himawari422/zynq7010-snore-detect/标定教程.md

# 呼噜声前端 阈值标定教程

> 适用：领航者 ZYNQ7010（ATK-DF7010P）+ Adafruit 3492 PDM 麦克风 + `snore_pdm` 工程
> 目标：把 `alarm_ctrl` 里三个估出来的门限（100 / 400 / 1200）换成**你这块板子、你这个房间**的实测值。

---

## 0. 前置条件（缺一不可）

| ☐ | 条件 | 怎么确认 |
|---|---|---|
| ☐ | 麦克风模块已接到 5 根杜邦线的另一端 | 5 个焊盘 3V/GND/CLK/DAT/SEL 全部接好 |
| ☐ | bit 已下载，板子上电 | 串口每 32ms 有一行 `F00xx P00xx A00xx` |
| ☐ | 串口跳线在 **PL 侧** | 有数据即说明已在 PL 侧 |
| ☐ | 串口助手已关闭 | **同一个 COM 口不能被两个程序占用** |
| ☐ | 环境就是实际使用环境 | 白天教室标定、夜里宿舍用 = 白标定 |

**先跑一次自检**：

```bash
python scripts\snore_mon.py COM7 3
```

能打印出帧统计就继续；打印 `收到 0 字节` 就回去查链路，别往下走。

---

## 1. 三个场景怎么造

### 场景 1：安静（底噪）
- 人不动、不说话，空调/风扇/电脑风扇**保持和平时一样开着**
- **不要刻意关掉环境噪音** —— 你标定的是"日常底噪"，不是"实验室底噪"
- 时长 20 秒足够

### 场景 2：正常说话
- 离麦克风 0.5~1m，用平常音量说一段话
- 这一段的用途是：验证"说话会点亮 LED1/LED2，但不该触发蜂鸣器"
- 时长 20 秒

### 场景 3：鼾声
三个来源，**优先用第一个**：

1. **手机播放鼾声录音**（最可控）：B 站/网易云搜"打呼噜 声音"、"snore sound"，音量调到跟真人打鼾差不多（大约 60~70 dB，比正常说话稍响）。手机放在麦克风 0.5~1m 处。
2. **真人打鼾**（最真实）：室友/家人配合，或自己对着麦克风模拟
3. **自己喉咙发"呼噜"音**（应急）：把手放在喉部振动，能出 80~200Hz 的低频调制声，频谱接近但强度偏低

> 时长 20~30 秒。**别只录 3 秒**，分位数统计需要足够样本。

---

## 2. 跑标定（推荐：一键脚本）

```bash
cd "C:\Users\Chen Yuhang\WorkBuddy\2026-10-27-17-18-16\snore_pdm"
"C:\Users\Chen Yuhang\.workbuddy\binaries\python\envs\default\Scripts\python.exe" scripts\calib.py COM7
```

脚本会依次提示三个场景，每段结束打印：

```
帧数=625  P50=18 P90=24 P99=31 Pmax=42  |  A50=6 A90=8
```

三段跑完，直接给出结论：

```
==============================================================
 标定结果
==============================================================
  底噪上沿  base =     31   (安静场景 P99)
  鼾声典型  sig  =    920   (鼾声场景 P50)
  信噪比    SNR  =   29.4 dB
  说话/底噪      =   12.3 倍

  建议门限（十进制 / 十六进制）：
    TH_LV1 = 47     (0x002F)   peak 超过它 -> LED1
    TH_LV2 = 169    (0x00A9)   peak 超过它 -> LED2 + 蜂鸣器
    TH_LV3 = 1840   (0x0730)   peak 超过它 -> LED3
```

**如果一次性把三段都跑完（中间靠环境切换）**，用：

```bash
python scripts\calib.py COM7 --no-prompt --d 20,20,25
```

---

## 3. 指标怎么读

| 指标 | 含义 | 合格线 |
|---|---|---|
| `P_p99`（安静） | 底噪的上沿 | 5~40 之间正常；`0000` 说明没信号 |
| `P_p50`（鼾声） | 鼾声的典型强度 | 至少是底噪的 **20 倍**以上 |
| **SNR** | 20·log10(鼾声/底噪) | **> 20 dB** 好做；< 12 dB 说明麦克风太远或增益不够 |
| `A_p50`（安静） | 均值绝对值 | 应该接近 0（5 以内），明显不为 0 说明有直流偏置 |
| 帧号跳变 | 丢帧 | 应该是 0 |

**不合格的典型表现**：

- 安静场景 `P_p99 = 0` 且 `P_max = 0` → DAT 没通
- 安静场景 `P_p99 = 32767` → DAT 悬空被拉高，或 CLK 没出来
- 鼾声与底噪差距 < 5 倍 → 麦克风太远 / 声音被挡 / 模块供电不足

---

## 4. 门限是怎么算出来的

```
base = 安静场景的 P99                # 底噪上沿
sig  = 鼾声场景的 P50                # 鼾声典型强度

TH_LV1 = 1.5 × base                  # 略高于底噪 -> "有声音"
TH_LV2 = √(base × sig)               # 对数尺度上的中点 -> "疑似鼾声"
TH_LV3 = 2.0 × sig                   # 明显超过鼾声 -> "很响"
```

**为什么 LV2 用几何平均而不是算术平均？**
音频幅值是指数分布的，算术中点会严重偏向大声那端，导致安静时也容易误触发。几何中点保证"底噪到它的倍数"和"它到鼾声的倍数"相等。

**为什么 LV1 只取 1.5 倍底噪？**
LV1 只是 LED 提示，不需要很严格；设得太高，稍远一点的声音就点不亮，看起来像坏了。

---

## 5. 写回源码并重新生成比特流

### 方式 A：自动写回（推荐）

```bash
python scripts\calib.py COM7 --patch
```

脚本会把三个值直接写进 `rtl/snore_top.v` 的 `alarm_ctrl` 实例化处。

### 方式 B：手动改

打开 `rtl/snore_top.v`，找到第 142 行附近：

```verilog
    alarm_ctrl #(
        .TH_LV1   (16'd100),      // <- 改成你的值
        .TH_LV2   (16'd400),      // <- 改成你的值
        .TH_LV3   (16'd1200),     // <- 改成你的值
        .TH_ON    (4),
        .BEEP_CYC (10_000_000)
    ) u_alarm (
```

### 重新综合（约 1~2 分钟）

```bash
cd "C:\Users\Chen Yuhang\WorkBuddy\2026-10-27-17-18-16\snore_pdm"
"D:\Xilinx\Vivado\2018.3\bin\vivado.bat" -mode batch -source scripts\build.tcl -tclargs C:\snore_impl impl
```

新的比特流在 `C:\snore_impl\snore_pdm.runs\impl_1\snore_top.bit`，把它复制回 `out\` 覆盖旧的，然后重新下载。

---

## 6. 验收标准

下载新 bit 后，按顺序自测：

| 动作 | 期望行为 |
|---|---|
| 安静 30 秒 | 三颗 LED 全灭，蜂鸣器不响 |
| 正常说话 | LED1 亮；偶尔 LED2 闪；**蜂鸣器不应该响** |
| 说一句停下 | LED 立刻熄灭（每 32ms 更新一次） |
| 持续放鼾声 | LED1/2/3 依次点亮，蜂鸣器每 128ms 一响（"嘀…嘀…"） |
| 拍一下手 | LED3 亮，蜂鸣器短响一声 |

**"嘀嘀"声的位置**由 `TH_ON` 控制（默认 4 帧 = 128ms 才触发一次蜂鸣）：
- 太灵敏、翻身就响 → 把 `TH_ON` 改成 8（256ms）
- 反应太慢 → 改成 2（64ms）

---

## 7. 常见问题

| 现象 | 原因 | 处理 |
|---|---|---|
| 安静时 LED1 一直亮 | TH_LV1 低于底噪 | 重新标定，或用 `--patch` 重跑 |
| 鼾声不点亮 LED3 | TH_LV3 太高，或麦克风太远 | TH_LV3 降到 `1.2 × 鼾声 P50` |
| 蜂鸣器一直在响 | TH_LV2 低于说话电平 | TH_LV2 提到 `√(底噪×鼾声) × 1.5` |
| LED 常亮且不随声音变化 | `LED_ACT_LOW` 极性反了 | 改 `snore_top.v` 第 22 行 |
| 标定过程中数值一直不变 | 麦克风没接/没供电 | 查 3V 与 DAT |
| 白天和夜里结果差很多 | 环境变了 | 用夜里实测数据重标一次 |

---

## 8. 一句话总结

**标定不是调参数玩，是把"底噪"和"鼾声"这两个真实电平量出来，然后在它们之间画两条线。** 只要 SNR > 20 dB，这三条线就画得很稳；如果 SNR 不到 12 dB，问题在声学（麦克风太远/被遮挡），改阈值救不回来。
