himawari422/zynq7010-snore-detect/docs/JTAG排针位置.png

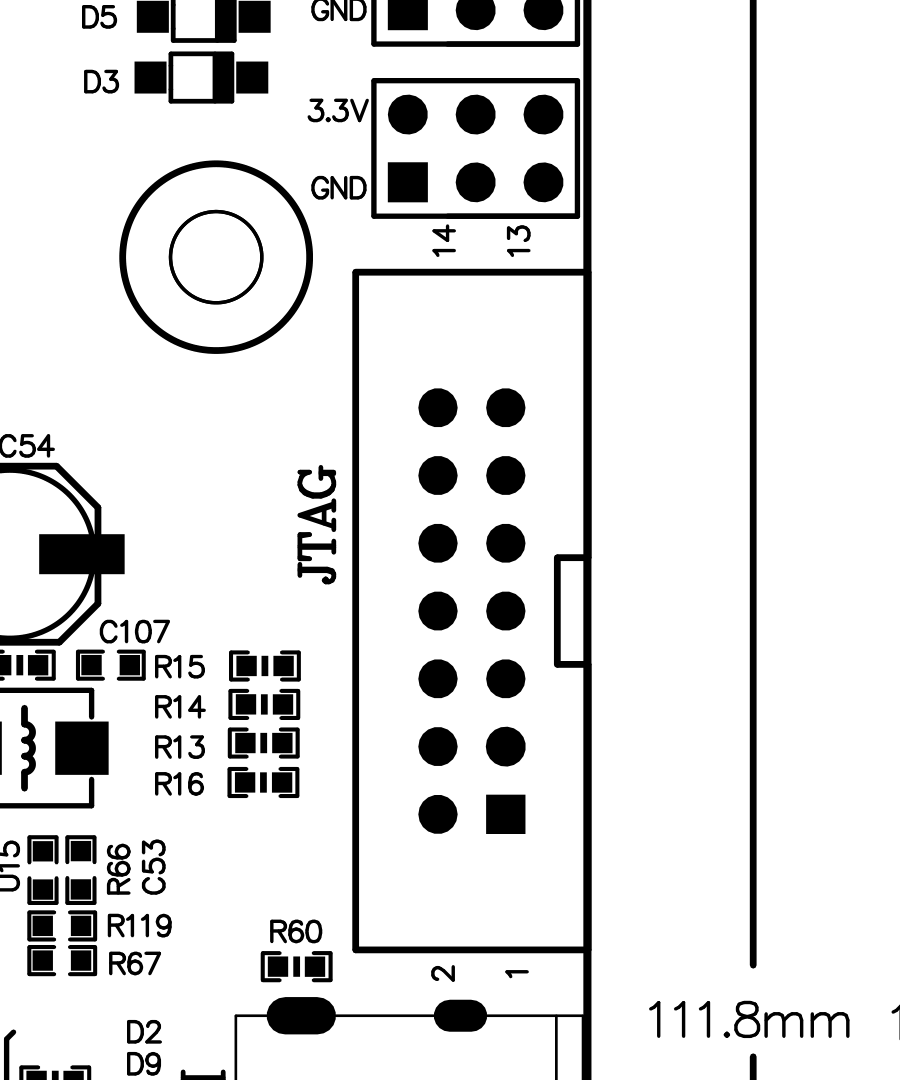
docs/JTAG排针位置.png
