himawari422/zynq7010-snore-detect/docs/P5周边位置.png

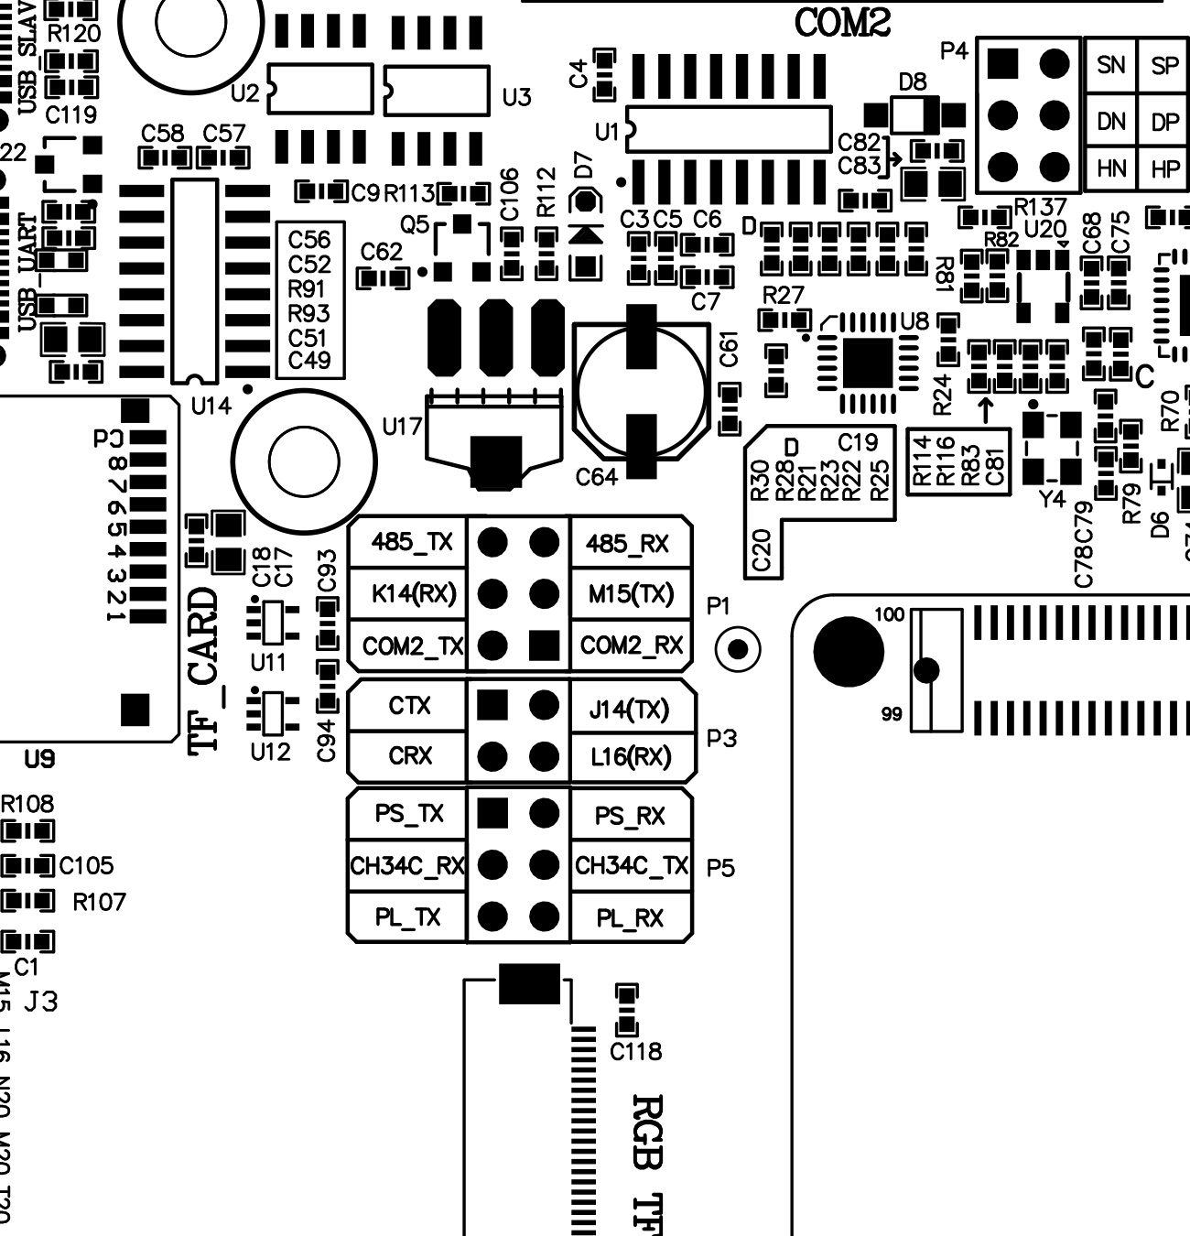
docs/P5周边位置.png
