himawari422/zynq7010-snore-detect/docs/P5当前状态_PS侧.png

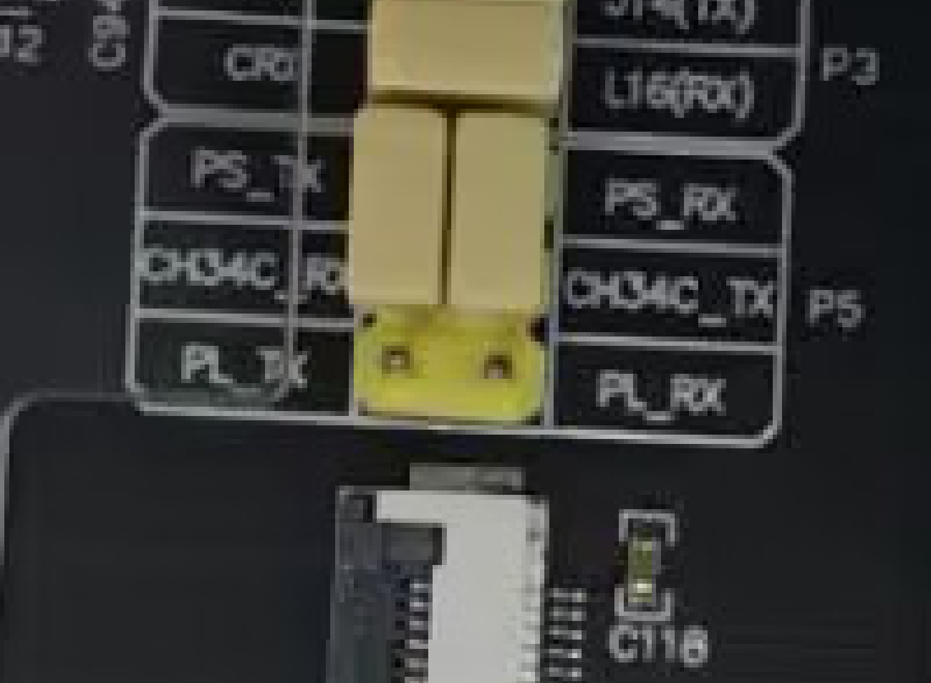
docs/P5当前状态_PS侧.png
