himawari422/zynq7010-snore-detect/docs/P5跳线丝印.png

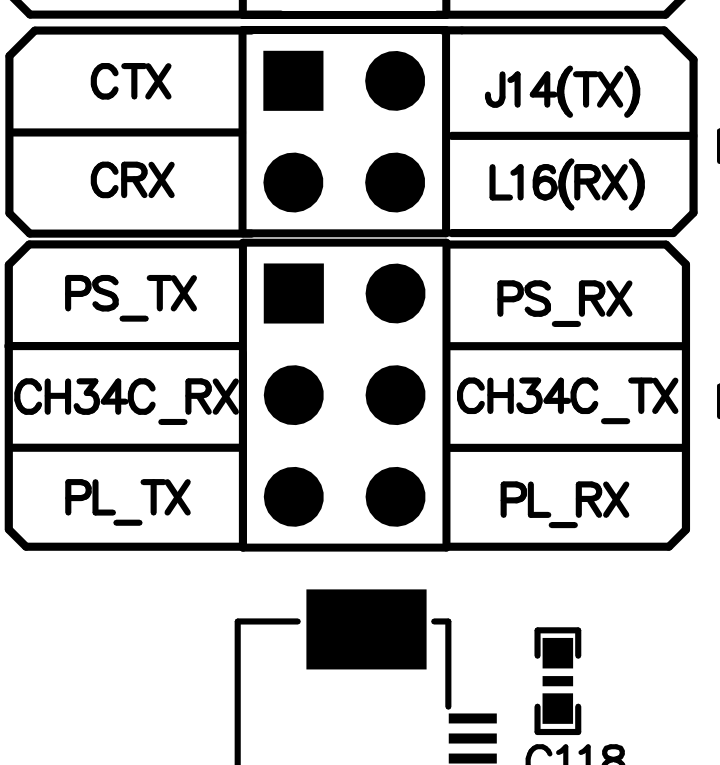
docs/P5跳线丝印.png
