himawari422/zynq7010-snore-detect/out/frame_high.png

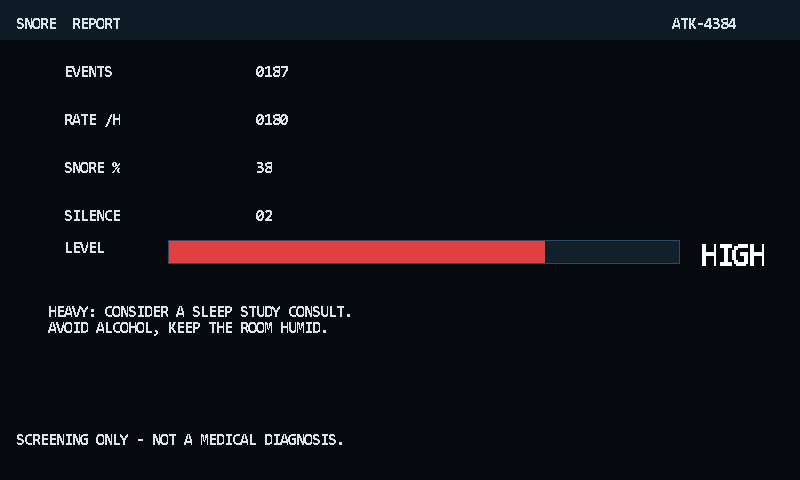
out/frame_high.png
