himawari422/zynq7010-snore-detect/out/frame_preview.png

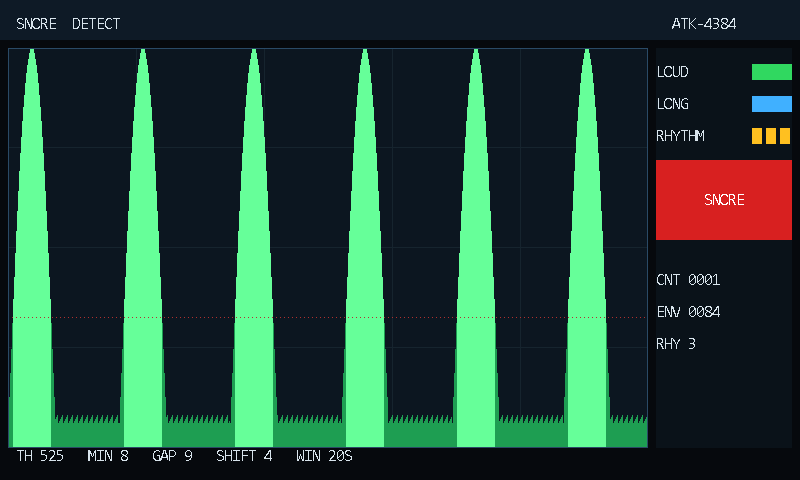
out/frame_preview.png
