himawari422/zynq7010-snore-detect/out/frame_quiet.png

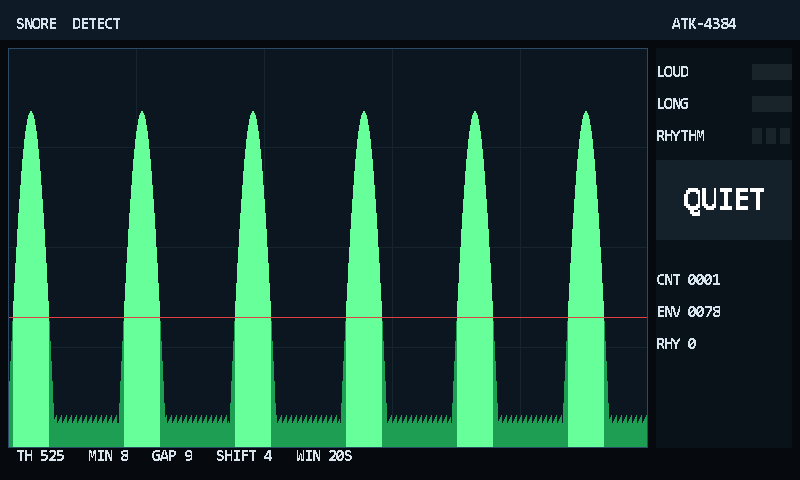
out/frame_quiet.png
