himawari422/zynq7010-snore-detect/out/frame_rt.png

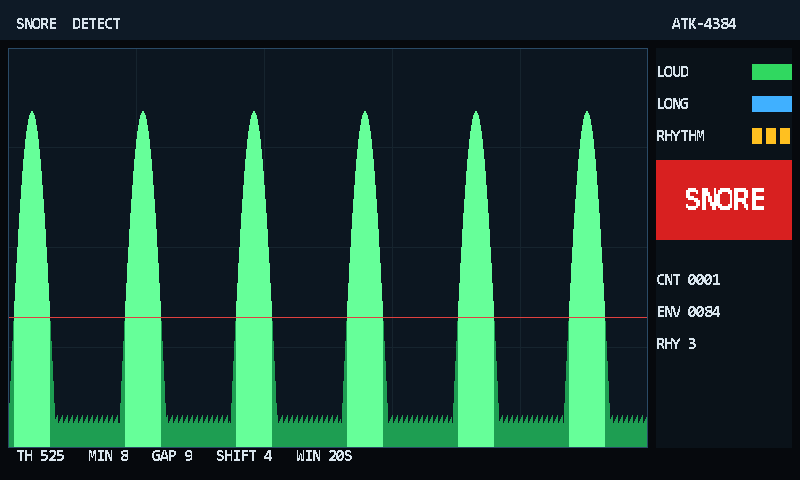
out/frame_rt.png
