himawari422/zynq7010-snore-detect/out/frame_wait.png

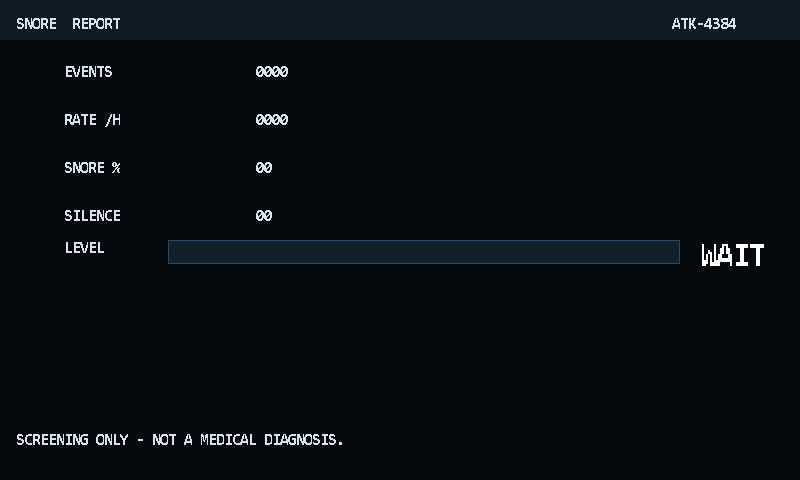
out/frame_wait.png
