himawari422/zynq7010-snore-detect/out/zoom_panel.png

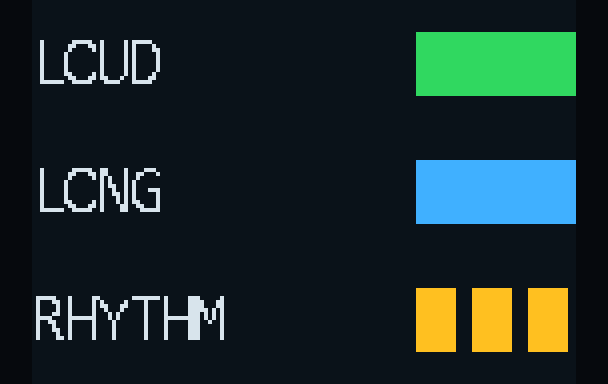
out/zoom_panel.png
