himawari422/zynq7010-snore-detect/out/zoom_verd.png

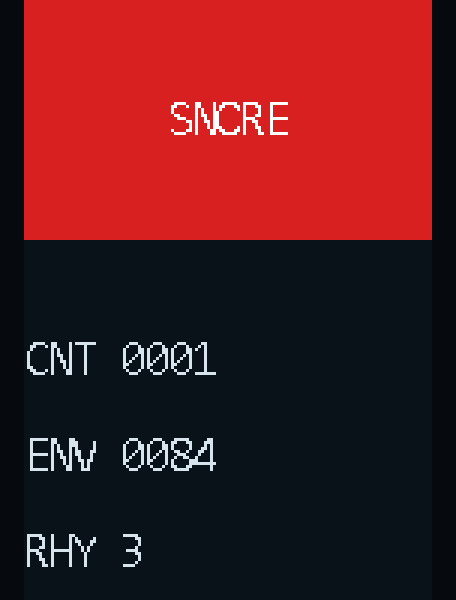
out/zoom_verd.png
