himawari422/zynq7010-snore-detect/auto_test.csv

t | seg | frame | P | A | E | S | C | R | G
-6.006 |  | 45434 | 102 | 74 | 135 | 0 | 0 | 0 | 0
-5.974 |  | 45435 | 138 | 71 | 138 | 0 | 0 | 0 | 0
-5.942 |  | 45436 | 141 | 76 | 141 | 0 | 0 | 0 | 0
-5.910 |  | 45437 | 106 | 75 | 133 | 0 | 0 | 0 | 0
-5.878 |  | 45438 | 105 | 82 | 125 | 0 | 0 | 0 | 0
-5.846 |  | 45439 | 100 | 69 | 118 | 0 | 0 | 0 | 0
-5.814 |  | 45440 | 114 | 85 | 111 | 0 | 0 | 0 | 0
-5.782 |  | 45441 | 147 | 73 | 147 | 0 | 0 | 0 | 0
-5.750 |  | 45442 | 233 | 90 | 233 | 0 | 0 | 0 | 0
-5.718 |  | 45443 | 147 | 71 | 219 | 0 | 0 | 0 | 0
-5.686 |  | 45444 | 154 | 80 | 206 | 0 | 0 | 0 | 0
-5.654 |  | 45445 | 132 | 68 | 194 | 0 | 0 | 0 | 0
-5.622 |  | 45446 | 137 | 80 | 182 | 0 | 0 | 0 | 0
-5.590 |  | 45447 | 123 | 70 | 171 | 0 | 0 | 0 | 0
-5.558 |  | 45448 | 127 | 81 | 161 | 0 | 0 | 0 | 0
-5.526 |  | 45449 | 137 | 79 | 151 | 0 | 0 | 0 | 0
-5.494 |  | 45450 | 151 | 85 | 151 | 0 | 0 | 0 | 0
-5.462 |  | 45451 | 144 | 78 | 142 | 0 | 0 | 0 | 0
-5.430 |  | 45452 | 142 | 84 | 142 | 0 | 0 | 0 | 0
-5.398 |  | 45453 | 109 | 75 | 134 | 0 | 0 | 0 | 0
-5.366 |  | 45454 | 128 | 88 | 126 | 0 | 0 | 0 | 0
-5.334 |  | 45455 | 169 | 76 | 169 | 0 | 0 | 0 | 0
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
