himawari422/zynq7010-snore-detect/snore_test.csv

t | seg | frame | P | A | E | S | C | R
-12.550 |  | 38344 | 86 | 69 | 95 | 0 | 0 | 0
-12.518 |  | 38345 | 86 | 72 | 90 | 0 | 0 | 0
-12.486 |  | 38346 | 80 | 63 | 85 | 0 | 0 | 0
-12.454 |  | 38347 | 85 | 67 | 80 | 0 | 0 | 0
-12.422 |  | 38348 | 78 | 64 | 85 | 0 | 0 | 0
-12.390 |  | 38349 | 88 | 72 | 80 | 0 | 0 | 0
-12.358 |  | 38350 | 86 | 70 | 88 | 0 | 0 | 0
-12.326 |  | 38351 | 76 | 61 | 83 | 0 | 0 | 0
-12.294 |  | 38352 | 82 | 60 | 78 | 0 | 0 | 0
-12.262 |  | 38353 | 73 | 56 | 82 | 0 | 0 | 0
-12.230 |  | 38354 | 66 | 46 | 77 | 0 | 0 | 0
-12.198 |  | 38355 | 64 | 52 | 73 | 0 | 0 | 0
-12.166 |  | 38356 | 67 | 50 | 69 | 0 | 0 | 0
-12.134 |  | 38357 | 68 | 56 | 65 | 0 | 0 | 0
-12.102 |  | 38358 | 66 | 53 | 68 | 0 | 0 | 0
-12.070 |  | 38359 | 72 | 56 | 64 | 0 | 0 | 0
-12.038 |  | 38360 | 59 | 43 | 72 | 0 | 0 | 0
-12.006 |  | 38361 | 55 | 40 | 68 | 0 | 0 | 0
-11.974 |  | 38362 | 53 | 39 | 64 | 0 | 0 | 0
-11.942 |  | 38363 | 58 | 44 | 60 | 0 | 0 | 0
-11.910 |  | 38364 | 65 | 49 | 57 | 0 | 0 | 0
-11.878 |  | 38365 | 66 | 45 | 65 | 0 | 0 | 0
-11.846 |  | 38366 | 61 | 48 | 66 | 0 | 0 | 0
-11.814 |  | 38367 | 61 | 42 | 62 | 0 | 0 | 0
-11.782 |  | 38368 | 68 | 49 | 59 | 0 | 0 | 0
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
