himawari422/zynq7010-snore-detect/rtl/text_layer_report.v

//=============================================================================
// text_layer_report.v  —  静态文字层（由 scripts/gen_lcd_assets.py 自动生成，勿手改）
//
//   输入字符单元坐标（col 0~99，row 0~29），输出该单元要显示的字符码。
//   没写字的地方一律返回空格，字库里空格是全零，画出来就是背景。
//
//   只存"有字的格子"，所以综合出来是一堆比较器，约 303 个单元。
//
//   建议文案三档分别放在 17/18、20/21、23/24 行，显示时按 level 加行偏移取用。
//=============================================================================
`timescale 1ns / 1ps

module text_layer_report (
    input  wire [6:0] col,     // 0~99
    input  wire [4:0] row,     // 0~29
    output reg  [7:0] ch
);

    always @(*) begin
        ch = 8'h20;             // 默认空格
        case ({row, col})
            12'd130  : ch = 8'h53;  // 'S'
            12'd131  : ch = 8'h4E;  // 'N'
            12'd132  : ch = 8'h4F;  // 'O'
            12'd133  : ch = 8'h52;  // 'R'
            12'd134  : ch = 8'h45;  // 'E'
            12'd135  : ch = 8'h20;  // 'space'
            12'd136  : ch = 8'h20;  // 'space'
            12'd137  : ch = 8'h52;  // 'R'
            12'd138  : ch = 8'h45;  // 'E'
            12'd139  : ch = 8'h50;  // 'P'
            12'd140  : ch = 8'h4F;  // 'O'
            12'd141  : ch = 8'h52;  // 'R'
            12'd142  : ch = 8'h54;  // 'T'
            12'd212  : ch = 8'h41;  // 'A'
            12'd213  : ch = 8'h54;  // 'T'
            12'd214  : ch = 8'h4B;  // 'K'
            12'd215  : ch = 8'h2D;  // '-'
            12'd216  : ch = 8'h34;  // '4'
            12'd217  : ch = 8'h33;  // '3'
            12'd218  : ch = 8'h38;  // '8'
            12'd219  : ch = 8'h34;  // '4'
            12'd520  : ch = 8'h45;  // 'E'
            12'd521  : ch = 8'h56;  // 'V'
            12'd522  : ch = 8'h45;  // 'E'
            12'd523  : ch = 8'h4E;  // 'N'
            12'd524  : ch = 8'h54;  // 'T'
            12'd525  : ch = 8'h53;  // 'S'
            12'd904  : ch = 8'h52;  // 'R'
            12'd905  : ch = 8'h41;  // 'A'
            12'd906  : ch = 8'h54;  // 'T'
            12'd907  : ch = 8'h45;  // 'E'
            12'd908  : ch = 8'h20;  // 'space'
            12'd909  : ch = 8'h2F;  // '/'
            12'd910  : ch = 8'h48;  // 'H'
            12'd1288 : ch = 8'h53;  // 'S'
            12'd1289 : ch = 8'h4E;  // 'N'
            12'd1290 : ch = 8'h4F;  // 'O'
            12'd1291 : ch = 8'h52;  // 'R'
            12'd1292 : ch = 8'h45;  // 'E'
            12'd1293 : ch = 8'h20;  // 'space'
            12'd1294 : ch = 8'h25;  // '%'
            12'd1672 : ch = 8'h53;  // 'S'
            12'd1673 : ch = 8'h49;  // 'I'
            12'd1674 : ch = 8'h4C;  // 'L'
            12'd1675 : ch = 8'h45;  // 'E'
            12'd1676 : ch = 8'h4E;  // 'N'
            12'd1677 : ch = 8'h43;  // 'C'
            12'd1678 : ch = 8'h45;  // 'E'
            12'd1928 : ch = 8'h4C;  // 'L'
            12'd1929 : ch = 8'h45;  // 'E'
            12'd1930 : ch = 8'h56;  // 'V'
            12'd1931 : ch = 8'h45;  // 'E'
            12'd1932 : ch = 8'h4C;  // 'L'
            12'd2438 : ch = 8'h4D;  // 'M'
            12'd2439 : ch = 8'h49;  // 'I'
            12'd2440 : ch = 8'h4C;  // 'L'
            12'd2441 : ch = 8'h44;  // 'D'
            12'd2442 : ch = 8'h3A;  // ':'
            12'd2443 : ch = 8'h20;  // 'space'
            12'd2444 : ch = 8'h4B;  // 'K'
            12'd2445 : ch = 8'h45;  // 'E'
            12'd2446 : ch = 8'h45;  // 'E'
            12'd2447 : ch = 8'h50;  // 'P'
            12'd2448 : ch = 8'h20;  // 'space'
            12'd2449 : ch = 8'h41;  // 'A'
            12'd2450 : ch = 8'h20;  // 'space'
            12'd2451 : ch = 8'h52;  // 'R'
            12'd2452 : ch = 8'h45;  // 'E'
            12'd2453 : ch = 8'h47;  // 'G'
            12'd2454 : ch = 8'h55;  // 'U'
            12'd2455 : ch = 8'h4C;  // 'L'
            12'd2456 : ch = 8'h41;  // 'A'
            12'd2457 : ch = 8'h52;  // 'R'
            12'd2458 : ch = 8'h20;  // 'space'
            12'd2459 : ch = 8'h53;  // 'S'
            12'd2460 : ch = 8'h4C;  // 'L'
            12'd2461 : ch = 8'h45;  // 'E'
            12'd2462 : ch = 8'h45;  // 'E'
            12'd2463 : ch = 8'h50;  // 'P'
            12'd2464 : ch = 8'h20;  // 'space'
            12'd2465 : ch = 8'h53;  // 'S'
            12'd2466 : ch = 8'h43;  // 'C'
            12'd2467 : ch = 8'h48;  // 'H'
            12'd2468 : ch = 8'h45;  // 'E'
            12'd2469 : ch = 8'h44;  // 'D'
            12'd2470 : ch = 8'h55;  // 'U'
            12'd2471 : ch = 8'h4C;  // 'L'
            12'd2472 : ch = 8'h45;  // 'E'
            12'd2473 : ch = 8'h2E;  // '.'
            12'd2566 : ch = 8'h41;  // 'A'
            12'd2567 : ch = 8'h56;  // 'V'
            12'd2568 : ch = 8'h4F;  // 'O'
            12'd2569 : ch = 8'h49;  // 'I'
            12'd2570 : ch = 8'h44;  // 'D'
            12'd2571 : ch = 8'h20;  // 'space'
            12'd2572 : ch = 8'h41;  // 'A'
            12'd2573 : ch = 8'h4C;  // 'L'
            12'd2574 : ch = 8'h43;  // 'C'
            12'd2575 : ch = 8'h4F;  // 'O'
            12'd2576 : ch = 8'h48;  // 'H'
            12'd2577 : ch = 8'h4F;  // 'O'
            12'd2578 : ch = 8'h4C;  // 'L'
            12'd2579 : ch = 8'h20;  // 'space'
            12'd2580 : ch = 8'h42;  // 'B'
            12'd2581 : ch = 8'h45;  // 'E'
            12'd2582 : ch = 8'h46;  // 'F'
            12'd2583 : ch = 8'h4F;  // 'O'
            12'd2584 : ch = 8'h52;  // 'R'
            12'd2585 : ch = 8'h45;  // 'E'
            12'd2586 : ch = 8'h20;  // 'space'
            12'd2587 : ch = 8'h42;  // 'B'
            12'd2588 : ch = 8'h45;  // 'E'
            12'd2589 : ch = 8'h44;  // 'D'
            12'd2590 : ch = 8'h54;  // 'T'
            12'd2591 : ch = 8'h49;  // 'I'
            12'd2592 : ch = 8'h4D;  // 'M'
            12'd2593 : ch = 8'h45;  // 'E'
            12'd2594 : ch = 8'h2E;  // '.'
            12'd2822 : ch = 8'h4D;  // 'M'
            12'd2823 : ch = 8'h4F;  // 'O'
            12'd2824 : ch = 8'h44;  // 'D'
            12'd2825 : ch = 8'h45;  // 'E'
            12'd2826 : ch = 8'h52;  // 'R'
            12'd2827 : ch = 8'h41;  // 'A'
            12'd2828 : ch = 8'h54;  // 'T'
            12'd2829 : ch = 8'h45;  // 'E'
            12'd2830 : ch = 8'h3A;  // ':'
            12'd2831 : ch = 8'h20;  // 'space'
            12'd2832 : ch = 8'h54;  // 'T'
            12'd2833 : ch = 8'h52;  // 'R'
            12'd2834 : ch = 8'h59;  // 'Y'
            12'd2835 : ch = 8'h20;  // 'space'
            12'd2836 : ch = 8'h53;  // 'S'
            12'd2837 : ch = 8'h4C;  // 'L'
            12'd2838 : ch = 8'h45;  // 'E'
            12'd2839 : ch = 8'h45;  // 'E'
            12'd2840 : ch = 8'h50;  // 'P'
            12'd2841 : ch = 8'h49;  // 'I'
            12'd2842 : ch = 8'h4E;  // 'N'
            12'd2843 : ch = 8'h47;  // 'G'
            12'd2844 : ch = 8'h20;  // 'space'
            12'd2845 : ch = 8'h4F;  // 'O'
            12'd2846 : ch = 8'h4E;  // 'N'
            12'd2847 : ch = 8'h20;  // 'space'
            12'd2848 : ch = 8'h59;  // 'Y'
            12'd2849 : ch = 8'h4F;  // 'O'
            12'd2850 : ch = 8'h55;  // 'U'
            12'd2851 : ch = 8'h52;  // 'R'
            12'd2852 : ch = 8'h20;  // 'space'
            12'd2853 : ch = 8'h53;  // 'S'
            12'd2854 : ch = 8'h49;  // 'I'
            12'd2855 : ch = 8'h44;  // 'D'
            12'd2856 : ch = 8'h45;  // 'E'
            12'd2857 : ch = 8'h2E;  // '.'
            12'd2950 : ch = 8'h4B;  // 'K'
            12'd2951 : ch = 8'h45;  // 'E'
            12'd2952 : ch = 8'h45;  // 'E'
            12'd2953 : ch = 8'h50;  // 'P'
            12'd2954 : ch = 8'h20;  // 'space'
            12'd2955 : ch = 8'h54;  // 'T'
            12'd2956 : ch = 8'h48;  // 'H'
            12'd2957 : ch = 8'h45;  // 'E'
            12'd2958 : ch = 8'h20;  // 'space'
            12'd2959 : ch = 8'h52;  // 'R'
            12'd2960 : ch = 8'h4F;  // 'O'
            12'd2961 : ch = 8'h4F;  // 'O'
            12'd2962 : ch = 8'h4D;  // 'M'
            12'd2963 : ch = 8'h20;  // 'space'
            12'd2964 : ch = 8'h48;  // 'H'
            12'd2965 : ch = 8'h55;  // 'U'
            12'd2966 : ch = 8'h4D;  // 'M'
            12'd2967 : ch = 8'h49;  // 'I'
            12'd2968 : ch = 8'h44;  // 'D'
            12'd2969 : ch = 8'h2C;  // ','
            12'd2970 : ch = 8'h20;  // 'space'
            12'd2971 : ch = 8'h41;  // 'A'
            12'd2972 : ch = 8'h56;  // 'V'
            12'd2973 : ch = 8'h4F;  // 'O'
            12'd2974 : ch = 8'h49;  // 'I'
            12'd2975 : ch = 8'h44;  // 'D'
            12'd2976 : ch = 8'h20;  // 'space'
            12'd2977 : ch = 8'h41;  // 'A'
            12'd2978 : ch = 8'h4C;  // 'L'
            12'd2979 : ch = 8'h43;  // 'C'
            12'd2980 : ch = 8'h4F;  // 'O'
            12'd2981 : ch = 8'h48;  // 'H'
            12'd2982 : ch = 8'h4F;  // 'O'
            12'd2983 : ch = 8'h4C;  // 'L'
            12'd2984 : ch = 8'h2E;  // '.'
            12'd3206 : ch = 8'h48;  // 'H'
            12'd3207 : ch = 8'h45;  // 'E'
            12'd3208 : ch = 8'h41;  // 'A'
            12'd3209 : ch = 8'h56;  // 'V'
            12'd3210 : ch = 8'h59;  // 'Y'
            12'd3211 : ch = 8'h3A;  // ':'
            12'd3212 : ch = 8'h20;  // 'space'
            12'd3213 : ch = 8'h43;  // 'C'
            12'd3214 : ch = 8'h4F;  // 'O'
            12'd3215 : ch = 8'h4E;  // 'N'
            12'd3216 : ch = 8'h53;  // 'S'
            12'd3217 : ch = 8'h49;  // 'I'
            12'd3218 : ch = 8'h44;  // 'D'
            12'd3219 : ch = 8'h45;  // 'E'
            12'd3220 : ch = 8'h52;  // 'R'
            12'd3221 : ch = 8'h20;  // 'space'
            12'd3222 : ch = 8'h41;  // 'A'
            12'd3223 : ch = 8'h20;  // 'space'
            12'd3224 : ch = 8'h53;  // 'S'
            12'd3225 : ch = 8'h4C;  // 'L'
            12'd3226 : ch = 8'h45;  // 'E'
            12'd3227 : ch = 8'h45;  // 'E'
            12'd3228 : ch = 8'h50;  // 'P'
            12'd3229 : ch = 8'h20;  // 'space'
            12'd3230 : ch = 8'h53;  // 'S'
            12'd3231 : ch = 8'h54;  // 'T'
            12'd3232 : ch = 8'h55;  // 'U'
            12'd3233 : ch = 8'h44;  // 'D'
            12'd3234 : ch = 8'h59;  // 'Y'
            12'd3235 : ch = 8'h20;  // 'space'
            12'd3236 : ch = 8'h43;  // 'C'
            12'd3237 : ch = 8'h4F;  // 'O'
            12'd3238 : ch = 8'h4E;  // 'N'
            12'd3239 : ch = 8'h53;  // 'S'
            12'd3240 : ch = 8'h55;  // 'U'
            12'd3241 : ch = 8'h4C;  // 'L'
            12'd3242 : ch = 8'h54;  // 'T'
            12'd3243 : ch = 8'h2E;  // '.'
            12'd3334 : ch = 8'h41;  // 'A'
            12'd3335 : ch = 8'h56;  // 'V'
            12'd3336 : ch = 8'h4F;  // 'O'
            12'd3337 : ch = 8'h49;  // 'I'
            12'd3338 : ch = 8'h44;  // 'D'
            12'd3339 : ch = 8'h20;  // 'space'
            12'd3340 : ch = 8'h41;  // 'A'
            12'd3341 : ch = 8'h4C;  // 'L'
            12'd3342 : ch = 8'h43;  // 'C'
            12'd3343 : ch = 8'h4F;  // 'O'
            12'd3344 : ch = 8'h48;  // 'H'
            12'd3345 : ch = 8'h4F;  // 'O'
            12'd3346 : ch = 8'h4C;  // 'L'
            12'd3347 : ch = 8'h2C;  // ','
            12'd3348 : ch = 8'h20;  // 'space'
            12'd3349 : ch = 8'h4B;  // 'K'
            12'd3350 : ch = 8'h45;  // 'E'
            12'd3351 : ch = 8'h45;  // 'E'
            12'd3352 : ch = 8'h50;  // 'P'
            12'd3353 : ch = 8'h20;  // 'space'
            12'd3354 : ch = 8'h54;  // 'T'
            12'd3355 : ch = 8'h48;  // 'H'
            12'd3356 : ch = 8'h45;  // 'E'
            12'd3357 : ch = 8'h20;  // 'space'
            12'd3358 : ch = 8'h52;  // 'R'
            12'd3359 : ch = 8'h4F;  // 'O'
            12'd3360 : ch = 8'h4F;  // 'O'
            12'd3361 : ch = 8'h4D;  // 'M'
            12'd3362 : ch = 8'h20;  // 'space'
            12'd3363 : ch = 8'h48;  // 'H'
            12'd3364 : ch = 8'h55;  // 'U'
            12'd3365 : ch = 8'h4D;  // 'M'
            12'd3366 : ch = 8'h49;  // 'I'
            12'd3367 : ch = 8'h44;  // 'D'
            12'd3368 : ch = 8'h2E;  // '.'
            12'd3458 : ch = 8'h53;  // 'S'
            12'd3459 : ch = 8'h43;  // 'C'
            12'd3460 : ch = 8'h52;  // 'R'
            12'd3461 : ch = 8'h45;  // 'E'
            12'd3462 : ch = 8'h45;  // 'E'
            12'd3463 : ch = 8'h4E;  // 'N'
            12'd3464 : ch = 8'h49;  // 'I'
            12'd3465 : ch = 8'h4E;  // 'N'
            12'd3466 : ch = 8'h47;  // 'G'
            12'd3467 : ch = 8'h20;  // 'space'
            12'd3468 : ch = 8'h4F;  // 'O'
            12'd3469 : ch = 8'h4E;  // 'N'
            12'd3470 : ch = 8'h4C;  // 'L'
            12'd3471 : ch = 8'h59;  // 'Y'
            12'd3472 : ch = 8'h20;  // 'space'
            12'd3473 : ch = 8'h2D;  // '-'
            12'd3474 : ch = 8'h20;  // 'space'
            12'd3475 : ch = 8'h4E;  // 'N'
            12'd3476 : ch = 8'h4F;  // 'O'
            12'd3477 : ch = 8'h54;  // 'T'
            12'd3478 : ch = 8'h20;  // 'space'
            12'd3479 : ch = 8'h41;  // 'A'
            12'd3480 : ch = 8'h20;  // 'space'
            12'd3481 : ch = 8'h4D;  // 'M'
            12'd3482 : ch = 8'h45;  // 'E'
            12'd3483 : ch = 8'h44;  // 'D'
            12'd3484 : ch = 8'h49;  // 'I'
            12'd3485 : ch = 8'h43;  // 'C'
            12'd3486 : ch = 8'h41;  // 'A'
            12'd3487 : ch = 8'h4C;  // 'L'
            12'd3488 : ch = 8'h20;  // 'space'
            12'd3489 : ch = 8'h44;  // 'D'
            12'd3490 : ch = 8'h49;  // 'I'
            12'd3491 : ch = 8'h41;  // 'A'
            12'd3492 : ch = 8'h47;  // 'G'
            12'd3493 : ch = 8'h4E;  // 'N'
            12'd3494 : ch = 8'h4F;  // 'O'
            12'd3495 : ch = 8'h53;  // 'S'
            12'd3496 : ch = 8'h49;  // 'I'
            12'd3497 : ch = 8'h53;  // 'S'
            12'd3498 : ch = 8'h2E;  // '.'
            default: ch = 8'h20;
        endcase
    end

endmodule
