himawari422/zynq7010-snore-detect/rtl/font_rom.v

//=============================================================================
// font_rom.v  —  8x16 ASCII 点阵（由 scripts/gen_lcd_assets.py 自动生成，勿手改）
//
//   接口刻意做成 function 形式而不是 RAM：
//     需要的是"任意坐标随时取一个字节"，用组合逻辑查表最直接，
//     综合成 LUT 后约 100 个 LUT6，比开一块 BRAM 更省事（也省一次读延迟）。
//
//   bits[7] 是最左边的像素，bits[0] 是最右边。
//=============================================================================
`timescale 1ns / 1ps

module font_rom (
    input  wire [7:0] ch,      // ASCII 字符码
    input  wire [3:0] row,     // 0~15 行
    output wire [7:0] bits     // 该行的 8 个像素
);

    reg [127:0] g;

    always @(*) begin
        case (ch)
            8'h20: g = 128'h00000000000000000000000000000000;  // 'space'
            8'h41: g = 128'h000000C1C1FF7F6363363636141C0000;  // 'A'
            8'h42: g = 128'h0000007C7E6363637E7E63637F7E0000;  // 'B'
            8'h43: g = 128'h0000000F3F306060606060303F0F0000;  // 'C'
            8'h44: g = 128'h0000007C7F636161616161637F7E0000;  // 'D'
            8'h45: g = 128'h0000003F3F3030303F3F30303F3F0000;  // 'E'
            8'h46: g = 128'h00000030303030303F3F30303F3F0000;  // 'F'
            8'h47: g = 128'h0000003E7F63C3C3CFCFC0607F1F0000;  // 'G'
            8'h48: g = 128'h00000061616161617F7F616161610000;  // 'H'
            8'h49: g = 128'h0000003F3F0C0C0C0C0C0C0C3F3F0000;  // 'I'
            8'h4A: g = 128'h000000387E460606060606067E7E0000;  // 'J'
            8'h4B: g = 128'h0000006367666C7C786C6C6E66670000;  // 'K'
            8'h4C: g = 128'h0000003F3F3030303030303030300000;  // 'L'
            8'h4D: g = 128'h00000041414149595555577777630000;  // 'M'
            8'h4E: g = 128'h000000636367676D6D6D797971710000;  // 'N'
            8'h4F: g = 128'h0000003E7FE3C1C1C1C1C1637F3E0000;  // 'O'
            8'h50: g = 128'h000000606060607C7E6363637F7C0000;  // 'P'
            8'h51: g = 128'h0F1F193E7FE3C1C1C1C1C1637F3E0000;  // 'Q'
            8'h52: g = 128'h000000616363667E7E6363637F7E0000;  // 'R'
            8'h53: g = 128'h0000003C7E4303073E7860627E3C0000;  // 'S'
            8'h54: g = 128'h0000000C0C0C0C0C0C0C0C0C7F7F0000;  // 'T'
            8'h55: g = 128'h0000001E3F7361616161616161610000;  // 'U'
            8'h56: g = 128'h0000001C1C363636636363E1C1C10000;  // 'V'
            8'h57: g = 128'h0000006777755555554D494141410000;  // 'W'
            8'h58: g = 128'h00000083C7E66C7C38387C7CE6C70000;  // 'X'
            8'h59: g = 128'h00000018181818183C3C66E7C3810000;  // 'Y'
            8'h5A: g = 128'h0000007F7F3018180C0606037F7F0000;  // 'Z'
            8'h30: g = 128'h0000003C7EE6E3F3DBCFC7677E3C0000;  // '0'
            8'h31: g = 128'h0000007F7F0C0C0C0C0C0C6C7C1C0000;  // '1'
            8'h32: g = 128'h0000007F7F381C0E060303237F3E0000;  // '2'
            8'h33: g = 128'h0000007C7E0303073E3C06067E7C0000;  // '3'
            8'h34: g = 128'h0000000606FFFFC66636361E1E0E0000;  // '4'
            8'h35: g = 128'h0000007C7E0703037F7C60607E7E0000;  // '5'
            8'h36: g = 128'h0000001E3F6161717F6F60303F0F0000;  // '6'
            8'h37: g = 128'h0000003018180C0C060703037F7F0000;  // '7'
            8'h38: g = 128'h0000003E7F6161371F3F61617F1F0000;  // '8'
            8'h39: g = 128'h0000003C3F03013D7F6161633F1E0000;  // '9'
            8'h3A: g = 128'h0000001C1C1C00001C1C1C0000000000;  // ':'
            8'h2D: g = 128'h000000000000003E3E00000000000000;  // '-'
            8'h3D: g = 128'h000000007F7F00007F7F000000000000;  // '='
            8'h2E: g = 128'h0000001C1C1C00000000000000000000;  // '.'
            8'h2F: g = 128'h0060303018180C0C0C06060303010000;  // '/'
            8'h25: g = 128'h000000C36626161B0C74DEDBD9700000;  // '%'
            8'h28: g = 128'h040E0C1818303030303018180C0E0400;  // '('
            8'h29: g = 128'h1038180C0C06060606060C0C18381000;  // ')'
            8'h2B: g = 128'h000000000C0C0C7F7F0C0C0C00000000;  // '+'
            8'h2C: g = 128'h30380C0C1C1800000000000000000000;  // ','
            default: g = 128'd0;
        endcase
    end

    // row*8 就是该行在 128 位常量里的起始位
    assign bits = g[({row, 3'b000}) +: 8];

endmodule
