himawari422/zynq7010-snore-detect/rtl/text_layer.v

//=============================================================================
// text_layer.v  —  静态文字层（由 scripts/gen_lcd_assets.py 自动生成，勿手改）
//
//   输入字符单元坐标（col 0~99，row 0~29），输出该单元要显示的字符码。
//   没写字的地方一律返回空格，字库里空格是全零，画出来就是背景。
//
//   只存"有字的格子"，所以综合出来是一堆比较器，约 86 个单元。
//=============================================================================
`timescale 1ns / 1ps

module text_layer (
    input  wire [6:0] col,     // 0~99
    input  wire [4:0] row,     // 0~29
    output reg  [7:0] ch
);

    always @(*) begin
        ch = 8'h20;             // 默认空格
        case ({row, col})
            12'd130  : ch = 8'h53;  // 'S'
            12'd131  : ch = 8'h4E;  // 'N'
            12'd132  : ch = 8'h4F;  // 'O'
            12'd133  : ch = 8'h52;  // 'R'
            12'd134  : ch = 8'h45;  // 'E'
            12'd135  : ch = 8'h20;  // 'space'
            12'd136  : ch = 8'h20;  // 'space'
            12'd137  : ch = 8'h44;  // 'D'
            12'd138  : ch = 8'h45;  // 'E'
            12'd139  : ch = 8'h54;  // 'T'
            12'd140  : ch = 8'h45;  // 'E'
            12'd141  : ch = 8'h43;  // 'C'
            12'd142  : ch = 8'h54;  // 'T'
            12'd212  : ch = 8'h41;  // 'A'
            12'd213  : ch = 8'h54;  // 'T'
            12'd214  : ch = 8'h4B;  // 'K'
            12'd215  : ch = 8'h2D;  // '-'
            12'd216  : ch = 8'h34;  // '4'
            12'd217  : ch = 8'h33;  // '3'
            12'd218  : ch = 8'h38;  // '8'
            12'd219  : ch = 8'h34;  // '4'
            12'd594  : ch = 8'h4C;  // 'L'
            12'd595  : ch = 8'h4F;  // 'O'
            12'd596  : ch = 8'h55;  // 'U'
            12'd597  : ch = 8'h44;  // 'D'
            12'd850  : ch = 8'h4C;  // 'L'
            12'd851  : ch = 8'h4F;  // 'O'
            12'd852  : ch = 8'h4E;  // 'N'
            12'd853  : ch = 8'h47;  // 'G'
            12'd1106 : ch = 8'h52;  // 'R'
            12'd1107 : ch = 8'h48;  // 'H'
            12'd1108 : ch = 8'h59;  // 'Y'
            12'd1109 : ch = 8'h54;  // 'T'
            12'd1110 : ch = 8'h48;  // 'H'
            12'd1111 : ch = 8'h4D;  // 'M'
            12'd2258 : ch = 8'h43;  // 'C'
            12'd2259 : ch = 8'h4E;  // 'N'
            12'd2260 : ch = 8'h54;  // 'T'
            12'd2514 : ch = 8'h45;  // 'E'
            12'd2515 : ch = 8'h4E;  // 'N'
            12'd2516 : ch = 8'h56;  // 'V'
            12'd2770 : ch = 8'h52;  // 'R'
            12'd2771 : ch = 8'h48;  // 'H'
            12'd2772 : ch = 8'h59;  // 'Y'
            12'd3586 : ch = 8'h54;  // 'T'
            12'd3587 : ch = 8'h48;  // 'H'
            12'd3588 : ch = 8'h20;  // 'space'
            12'd3589 : ch = 8'h35;  // '5'
            12'd3590 : ch = 8'h32;  // '2'
            12'd3591 : ch = 8'h35;  // '5'
            12'd3592 : ch = 8'h20;  // 'space'
            12'd3593 : ch = 8'h20;  // 'space'
            12'd3594 : ch = 8'h20;  // 'space'
            12'd3595 : ch = 8'h4D;  // 'M'
            12'd3596 : ch = 8'h49;  // 'I'
            12'd3597 : ch = 8'h4E;  // 'N'
            12'd3598 : ch = 8'h20;  // 'space'
            12'd3599 : ch = 8'h38;  // '8'
            12'd3600 : ch = 8'h20;  // 'space'
            12'd3601 : ch = 8'h20;  // 'space'
            12'd3602 : ch = 8'h20;  // 'space'
            12'd3603 : ch = 8'h47;  // 'G'
            12'd3604 : ch = 8'h41;  // 'A'
            12'd3605 : ch = 8'h50;  // 'P'
            12'd3606 : ch = 8'h20;  // 'space'
            12'd3607 : ch = 8'h39;  // '9'
            12'd3608 : ch = 8'h20;  // 'space'
            12'd3609 : ch = 8'h20;  // 'space'
            12'd3610 : ch = 8'h20;  // 'space'
            12'd3611 : ch = 8'h53;  // 'S'
            12'd3612 : ch = 8'h48;  // 'H'
            12'd3613 : ch = 8'h49;  // 'I'
            12'd3614 : ch = 8'h46;  // 'F'
            12'd3615 : ch = 8'h54;  // 'T'
            12'd3616 : ch = 8'h20;  // 'space'
            12'd3617 : ch = 8'h34;  // '4'
            12'd3618 : ch = 8'h20;  // 'space'
            12'd3619 : ch = 8'h20;  // 'space'
            12'd3620 : ch = 8'h20;  // 'space'
            12'd3621 : ch = 8'h57;  // 'W'
            12'd3622 : ch = 8'h49;  // 'I'
            12'd3623 : ch = 8'h4E;  // 'N'
            12'd3624 : ch = 8'h20;  // 'space'
            12'd3625 : ch = 8'h32;  // '2'
            12'd3626 : ch = 8'h30;  // '0'
            12'd3627 : ch = 8'h53;  // 'S'
            default: ch = 8'h20;
        endcase
    end

endmodule
